benderL101/arcade-stick/hardware/io-board/arcade_stick_io.kicad_pcb

## KiCad design hardware/io-board/arcade_stick_io.kicad_pcb (2026-10-27)

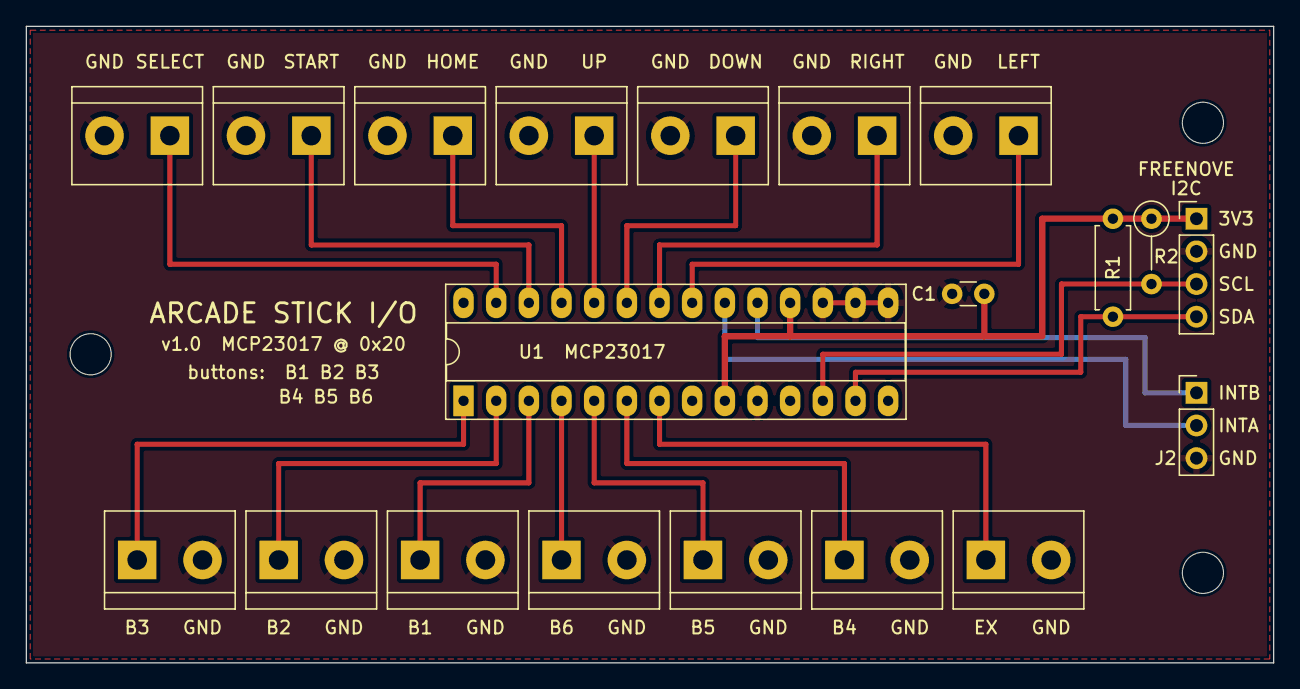
[picture p3: board arcade_stick_io.kicad_pcb from above]

Board: 2 copper layers, 97.0 x 49.5 mm, 23 parts (0 on the bottom side), 20 nets.

Parts:
C1: 100nF; C_Disc_D3.0mm_W1.6mm_P2.50mm
H1, H2, H3: MountingHole_3.2mm_M3
J1: I2C to Freenove; PinHeader_1x04_P2.54mm_Vertical
J2: INT (spare); PinHeader_1x03_P2.54mm_Vertical
JB1, JB2, JB3, JB4, JB5, JB6, JB7: Screw terminal 2P 5.08; TerminalBlock_bornier-2_P5.08mm
JT1, JT2, JT3, JT4, JT5, JT6, JT7: Screw terminal 2P 5.08; TerminalBlock_bornier-2_P5.08mm
R1: 4.7k; R_Axial_DIN0207_L6.3mm_D2.5mm_P7.62mm_Horizontal
R2: 4.7k; R_Axial_DIN0207_L6.3mm_D2.5mm_P5.08mm_Vertical
U1: MCP23017-E/SP; DIP-28_W7.62mm_Socket_LongPads

Connections:
3V3: C1.1, J1.1, R1.1, R2.1, U1.9, U1.18
B1: JB3.1, U1.3
B2: JB2.1, U1.2
B3: JB1.1, U1.1
B4: JB6.1, U1.6
B5: JB5.1, U1.5
B6: JB4.1, U1.4
DOWN: JT5.1, U1.23
EX: JB7.1, U1.7
GND: C1.2, J1.2, J2.3, JB1.2, JB2.2, JB3.2, JB4.2, JB5.2, JB6.2, JB7.2, JT1.2, JT2.2, JT3.2, JT4.2, JT5.2, JT6.2, JT7.2, U1.10, U1.15, U1.16, U1.17
HOME: JT3.1, U1.25
INTA: J2.2, U1.20
INTB: J2.1, U1.19
LEFT: JT7.1, U1.21
RIGHT: JT6.1, U1.22
SCL: J1.3, R2.2, U1.12
SDA: J1.4, R1.2, U1.13
SELECT: JT1.1, U1.27
START: JT2.1, U1.26
UP: JT4.1, U1.24
