benderL101/arcade-stick/(commit log)

2026-10-26 v2.4: one firmware for every stick
    Stick colour (accent, Bluetooth/USB/Wi-Fi name) and wiring are now chosen in
    the stick's menu. Blue's wiring is the standard; the original red stick uses
    Wiring -> Old red stick, detected automatically on first boot from the
    firmware it replaced. Releases keep _red/_blue_wifi copies for v2.3 sticks.
    Claude-Session: https://claude.ai/code/session_0183fLGnf4bUpL4iQg2qP2nU
    [main.cpp]
2026-10-27 Add I/O board v1.0 for building more sticks
    Through-hole MCP23017 carrier with a screw terminal per input, laid out to
    the standard wiring. KiCad 7 board generated by make_board.py, DRC clean,
    netlist checked against the datasheet and MCP_BIT_STD by check_board.py.
    JLCPCB Gerber zip, parts list and build guide included.
    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
    [arcade_stick_io-B_Cu.gbl, arcade_stick_io-B_Mask.gbs, arcade_stick_io-B_Silkscreen.gbo, arcade_stick_io-Edge_Cuts.gm1, arcade_stick_io-F_Cu.gtl, arcade_stick_io-F_Mask.gts, arcade_stick_io-F_Silkscreen.gto, arcade_stick_io-NPTH.drl]
2026-10-27 v2.5: Game link labels, combo trainer, faster BT check, auto-built releases
    - Game link: joins home Wi-Fi alongside Bluetooth, asks RetroArch which game
    is running (GET_STATUS, UDP 55355) and shows per-game button labels typed
    on a phone at the stick's own web page (stored in LittleFS, keyed by
    RetroArch button so they follow the profile).
    - Combo trainer: one move at a time with feedback (wrong button, missed
    direction, too slow, too late, short charge...), 3 in a row moves on.
    - Bluetooth: check the interval the host agreed to, re-ask once if slow,
    show it on Input test.
    - GitHub Action builds and attaches the release files when a release is
    published; libraries pinned to git t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
    [main.cpp, moves.h, test_gamelink.py, test_moves.cpp]
